mwelling/96boards-robomezzi/README.md

# 96boards-robomezzi

This repository contains the hardware design files for a robotics mezzanine
board that plugs into 96boards CE based products.

## Hardware Specs

- 16 PWM servo outputs
- 8 5V GPIO
- 4 5V Analog Inputs
- 9DOF sensor
- 6V servo switching regulator
- 5V I2C header
- FTDI debug UART

## License

96boards-robomezzi (c) 2015 by QWERTY Embedded Design

96boards-robomezzi is licensed under a
Creative Commons Attribution-ShareAlike 4.0 International License.

[License Information](http://creativecommons.org/licenses/by-sa/4.0/)
