mwelling/96boards-robomezzi/96boards-robomezzi.pdf

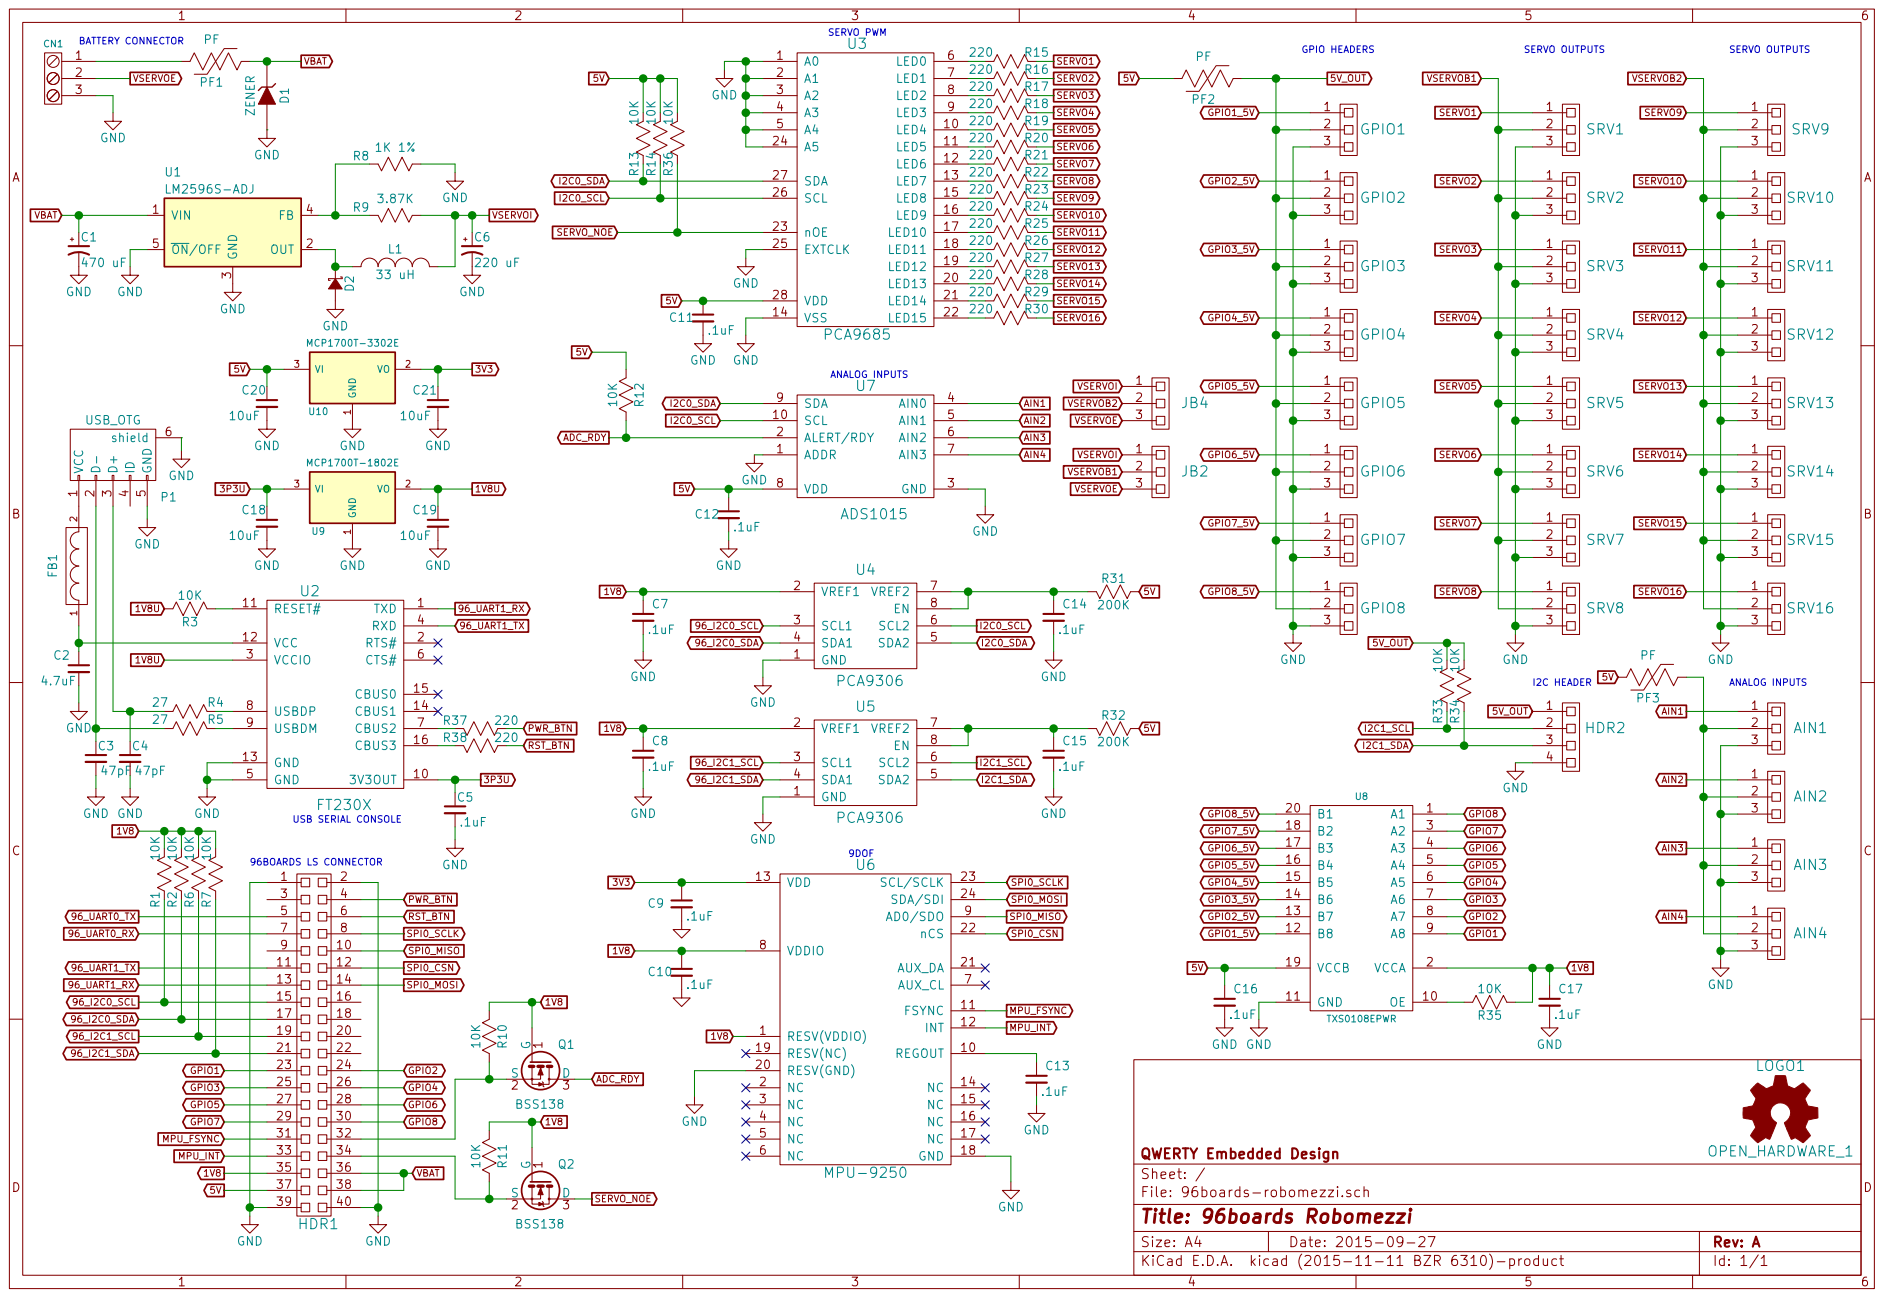
[picture p1: page 1]

Id: 1/1 Title: 96boards Robomezzi File: 96boards-robomezzi.sch Sheet: / QWERTY Embedded Design
