mwelling/96boards-robomezzi/(commit log)

2015-09-30 Schematic and PCB updates
    Adds schematic sheet with some of the headers and buttons.
    Adds PCB sheet with basic board outline.
    Adds schematic library for handful of new components.
    [96boards-robomezzi.kicad_pcb, 96boards-robomezzi.sch]
2015-10-02 Add 9DOF IMU
    The MPU-9150 provides 9 degrees of freedom in a single chip.
    [96boards-robomezzi.sch]
2015-10-02 Update to new 9DOF IMU :-/
    Now using the MPU-9250 instead.
    The MPU-9150 is not recommended for new designs. (NRND)
    Note-to-self: Always check part's availibility before wasting time making
    a schematic symbol or footprint.
    [96boards-robomezzi.sch]
2015-10-08 Add PCA9685 LED / PWM output chip
    Using chip for dedicated servo outputs.
    [96boards-robomezzi.sch]
2015-11-16 Add USB serial console and I2C level translator
    TODO:
    Allow for selection of UART with jumpers.
    [96boards-robomezzi.sch]
2015-11-28 Add 4 analog inputs and UART selection jumpers
    Added ADS1015 four input 12 bit ADC and input headers.
    Added jumper bank for USB UART selection.
    [96boards-robomezzi.sch]
2015-11-29 Add 6V servo regulator, GPIO translators / headers
    - Vservo supplied with LM2596S-ADJ
    - GPIO translated with TXS0108EPWR
    - Level translated GPIO and I2C brought to headers
    [96boards-robomezzi.sch]
2015-11-30 Updates per review from David Anders
    - Using PCA9306 for I2C level shifters
    - Adds polyfuse to 5V and 6V outputs to headers
    - Switches battery fuse to polyfuse
    - Connects PWM nOE signal to lowspeed header
    TODO: Define polyfuse ratings based on max current requirements.
    [96boards-robomezzi.sch]
2015-12-05 Switch add external Vservo and change GPIO headers
    - Use 3 pin headers for GPIO
    - Add 3 pin to power terminal for Vservo
    - Add jumpers to select Vservo from header or regulator
    [96boards-robomezzi.kicad_pcb, 96boards-robomezzi.sch]
2015-12-07 Some PCB footprints added and initial placement
    Still need to added footprints for the push buttons and 2mm low speed header.
    [96boards-robomezzi.kicad_pcb, 96boards-robomezzi.sch]
2015-12-12 Change a lot of things all at once
    TODO: Add consummate wiggly tracks.
    [96boards-robomezzi.kicad_pcb, 96boards-robomezzi.sch]
2015-12-17 Routing completed
    [96boards-robomezzi.kicad_pcb, 96boards-robomezzi.sch]
2015-12-18 Tweak routing, plot schematic pdf and layout gerbers
    Almost ready for PCB R0.
    [96boards-robomezzi-B.Adhes.gbr, 96boards-robomezzi-B.Cu.gbl, 96boards-robomezzi-B.Cu.gbr, 96boards-robomezzi-B.Mask.gbr, 96boards-robomezzi-B.Mask.gbs, 96boards-robomezzi-B.Paste.gbp, 96boards-robomezzi-B.Paste.gbr, 96boards-robomezzi-B.SilkS.gbr]
2015-12-18 Update gerbers and remove .zip file
    [96boards-robomezzi-B.Adhes.gbr, 96boards-robomezzi-B.Cu.gbl, 96boards-robomezzi-B.Cu.gbr, 96boards-robomezzi-B.Mask.gbr, 96boards-robomezzi-B.Mask.gbs, 96boards-robomezzi-B.Paste.gbp, 96boards-robomezzi-B.Paste.gbr, 96boards-robomezzi-B.SilkS.gbr]
2015-12-21 Update switching inductor and silkscreen
    [96boards-robomezzi-B.Adhes.gbr, 96boards-robomezzi-B.Cu.gbr, 96boards-robomezzi-B.Mask.gbr, 96boards-robomezzi-B.Paste.gbr, 96boards-robomezzi-B.SilkS.gbr, 96boards-robomezzi-Edge.Cuts.gbr, 96boards-robomezzi-F.Adhes.gbr, 96boards-robomezzi-F.Cu.gbr]
2015-12-22 Switch to through hole polyfuse
    Required based on the current requirements.
    [96boards-robomezzi-B.Adhes.gbr, 96boards-robomezzi-B.Cu.gbr, 96boards-robomezzi-B.Mask.gbr, 96boards-robomezzi-B.Paste.gbr, 96boards-robomezzi-B.SilkS.gbr, 96boards-robomezzi-Edge.Cuts.gbr, 96boards-robomezzi-F.Adhes.gbr, 96boards-robomezzi-F.Cu.gbr]
2015-12-24 Switch to 12mil vias with 6mil anualar ring
    Updated pours and slightly tweaked routing too.
    [96boards-robomezzi.kicad_pcb]
2015-12-24 Update gerbers with newest changes
    [96boards-robomezzi-B.Adhes.gbr, 96boards-robomezzi-B.Cu.gbr, 96boards-robomezzi-B.Mask.gbr, 96boards-robomezzi-B.Paste.gbr, 96boards-robomezzi-B.SilkS.gbr, 96boards-robomezzi-Edge.Cuts.gbr, 96boards-robomezzi-F.Adhes.gbr, 96boards-robomezzi-F.Cu.gbr]
2016-01-18 Measure twice, cut once
